maxxcantu/microcontroladores/README.md

# microcontroladores

Final Project.
University: Universidad Nacional de Cuyo.
Subject: Microcontrollers and Power Electronics.
Project: Prototype of a light folower differential drive mobile robot.
Developed in an Atmel328P microcontroller in Microchip Studio environment, simulated in Proteus and physically builded.

In this repository you can see all the code files in C, the simulation file of Proteus and the project report in spanish.
Also there is a demonstrative video to see the robot builded and in function.
