maxxcantu/microcontroladores/MyEP Informe Proyecto Integrador-Cantu_v2.pdf

Mendoza - Argentina

# PROTOTIPO DE ROBOT ASISTIDOR DE

# COSECHA

PROYECTO INTEGRADOR

Microcontroladores y Electronica de Potencia ´ Profesor Titular: Ing. Eduardo E. Iriarte

Cantu Tsallis, Maximiliano – 11294 ´

Ano: 2022 ˜

Proyecto Integrador - Prototipo Robot Asistidor de Cosecha | Cantu Tsallis, Maximiliano ´

# RESUMEN

El objetivo principal del proyecto es lograr disenar, simular y controlar el movimiento de un proto- ˜ tipo físico y a escala de un robot asistidor de cosecha, el cual sea capaz de seguir constantemente al operario durante el proceso, transportando el cajon de uva a una distancia y velocidad deseada. ´ Esto es con el fin de evitarle al operario el trabajo de cargar, trasladar y descargar el cajon cada ´ vez que necesite moverse, ya que esos movimientos suelen ser de distancias cortas y resulta agotador realizarlos repetidas veces en poco tiempo, generando un desgaste corporal y una perdida de tiempo.
Para lograrlo, se desarrollara un modelo a escala con simplificaciones y diferencias respecto al ´
proyecto final, las cuales se tendran en cuenta como mejoras a futuro para completar la realizaci ´ | on´
y fabricacion del proyecto en su totalidad. ´
MICROCONTROLADORES Y ELECTRONICA DE POTENCIA | 1 de 19 ´

## Índice

RESUMEN | 1
INTRODUCCION´ | 3
DESARROLLO | | | 5
1. Descripcion de l ´ | ogica y conexiones de hardware ´ | 5
2. Descripcion de perif ´ | ericos y c ´ | odigo ´ | 10
3. Funcionamiento General | 13
PUESTA EN MARCHA | 15
ANALISIS DE INGENIER ´ | ÍA | 17
CONCLUSIONES | 18
REFERENCIAS | 19

# INTRODUCCION´

El proyecto que se presenta a continuacion tiene como objetivo la aplicaci ´ | on de los conocimientos ´
adquiridos en la catedra de Microcontroladores y Electr ´ | onica de Potencia de la carrera de Ingenier ´ | ía
en Mecatronica en la Universidad Nacional de Cuyo. ´
La idea de realizar este proyecto surge de una experiencia propia vivida el ano pasado, cuando ˜ tuve que trabajar haciendo temporada en la cosecha de uva de lunes a lunes todo el día. Mientras realizaba mi trabajo notaba que había acciones simples, pero repetitivas, y que con el correr de los días se tornaban cada vez mas desgastantes por el cansancio y la fatiga que el cuerpo iba acumu- ´ lando. Una de ellas era la de cargar y descargar el cajon de uvas a medida que se iba avanzando ´ con la cosecha sobre la hilera de parcelas, lo cual era muy frecuente ya que como la distribucion de ´
los racimos no era homogenea, hab ´ | ía sectores con gran cantidad de racimos para cosechar, lo cual
equivale a mayor tiempo en una misma posicion, pero hab ´ | ían otros sectores con muy pocos raci-
mos en los que se perdía mas tiempo trasladando el caj ´ | on, parcialmente lleno de uva, unos pocos ´
metros para continuar el proceso. Es por esto que me surge la necesidad de pensar una forma para evitar dicho desgaste físico y perdida de tiempo, totalmente desfavorable para el objetivo principal ´ del trabajo, el cual era cosechar la mayor cantidad de uva de buena calidad y en el menor tiempo posible.
Como bien es sabido, en los pueblos o regiones en los que la actividad vitivinícola es uno de
sus pilares economicos, la ´ | epoca de vendimia es una costumbre y una tradici ´ | on compartida entre ´
familiares, amigos y vecinos y de la cual todos forman parte en diferentes etapas del proceso, por lo
tanto, no esta bien visto el reemplazar completamente el proceso de cosecha por robots o m ´ | aquinas ´
automatizadas que lo realicen; y ademas, la correcta selecci ´ | on de la uva tambi ´ | en es muy importante ´
para obtener un buen producto final y de calidad. Por otro lado, tambien hay que tener en cuenta el ´
factor economico, el cual tambi ´ | en es muy importante, ya que no se justifica invertir grandes sumas ´
de dinero por una maquina cosechadora si realizarlo manualmente es m ´ | | as barato y se obtiene un ´
mejor producto final.
Teniendo en cuenta las limitaciones previamente mencionadas, es que pienso en los robots colaborativos, los cuales son destinados a trabajar en conjunto con un operario, pero sin quitarle el trabajo por completo al mismo. Logrando crear un robot que sea capaz de resolver el problema principal, el de cargar y trasladar los cajones repetidas veces en un periodo corto de tiempo, pero sin
interferir en el proceso de seleccion y cosecha del fruto, ser ´ | ía lo ideal para lograr una cosecha mas´
rapida y con una peque ´ | na mejor ˜ | ía en cuanto al desgaste físico del operario; y sin necesidad de inver-
tir grandes sumas de dinero en la compra de maquinas cosechadoras o vendimiadoras industriales, ´ que rondan valores entre los US$250.000 y los US$350.000, aproximadamente.
La idea global del proyecto es implementar un robot diferencial de orugas, debido a que su apli-
cacion seria principalmente en terrenos hostiles y dificultosos, no se requerir ´ | an altas velocidades de ´
movimientos y si sera necesaria una gran tracci ´ | on en el terreno para trasladar cargar entre los 2 ´
y los 20 kilogramos aproximadamente. El movimiento sería guiado por una tobillera colocada en el
operario y con comunicacion infrarroja con el aut ´ | omata, de manera que pueda sensar y calcular la ´
distancia a la cual se encuentra el operario, es decir la tobillera, y mediante una logica determinar ´ si es necesario moverse hacia adelante para seguir al operario o moverse hacia atras para alejarse ´
del mismo. Ademas, dependiendo de la direcci ´ | on de la cual proviene la se ´ | nal infrarroja, el aut ˜ | omata ´
sería capaz de girar hacia un lado o hacia el otro, mediante la activacion de uno de los motores ´ | uni- ´
camente; cuando el operario deba girar en una hilera o comenzar con una nueva. El robot contaría con un potenciometro para que el operario pueda modificar manualmente y a su gusto la velocidad ´
de movimiento hacia adelante y hacia atras, seg ´ | un sea necesario; la velocidad de giro ser ´ | ía cons-
tante sin posibilidad de modificarse. Se opta por colocar un potenciometro en lugar de panel t ´ | actil, ´
teclado numerico o interfaz LCD, debido a que el ambiente tambi ´ | en seria hostil y el robot deber ´ | ía
ser lo mas rudimentario y robusto posible, y tambi ´ | en debido a que se debe tener en cuenta que el ´
operario tendría guantes con suciedad colocados. Por ultimo, el operario contar ´ | ía con un pulsador

sin retencion para setear el robot en un estado de reposo y que el mismo no lo siga hasta que se ´ vuelva a presionar el mismo pulsador; esto sería util en el caso que el operario desee alejarse del ´ mismo para realizar alguna tarea temporal en la cual no requiera el seguimiento del robot.
Para el presente proyecto, se optaría por hacer algunas modificaciones a lo previamente mencionado debido a que la idea global completa sería considerada para presentarla como proyecto final de
la carrera, implementandole conceptos y pr ´ | acticas de diferentes materias. Se modificar ´ | an los sen- ´
sores infrarrojos por sensores de luz tipo LDR, 3 para ser mas espec ´ | ífico, 1 sensor frontal, 1 sensor
lateral izquierdo y 1 sensor lateral derecho. Las orugas se reemplazaran por 2 ruedas traseras con- ´ ducidas por 2 motorreductores de CC controlados por 1 controlador L298N y 1 rueda “loca” frontal.
El automata ser ´ | ía alimentado por una batería externa recargable, la cual sea facilmente extra ´ | íble y
reemplazable si llega a ser necesario.
En este informe se expondra la l ´ | ogica de funcionamiento del robot, as ´ | í como el codigo realizado ´
y cargado en el microcontrolador, la implementacion del prototipo, sus conexiones el ´ | ectricas y su ´
montaje final con las partes mecanicas necesarias. ´

# DESARROLLO

1. Descripcion de l ´ | ogica y conexiones de hardware ´
En el desarrollo del automata, primero se ide ´ | o la l ´ | ogica de funcionamiento, la cual est ´ | a dada en ´
la Figura 1 y se tienen en cuenta los diferentes movimientos del robot en funcion de la intensidad y ´ de la direccion de la luz incidente en los sensores. Se configuraron 4 valores constantes de luz para ´
la comparacion, los cuales generan una banda proporcional de velocidades de movimientos seg ´ | un´
la intensidad de luz recibida por el sensor frontal. Esta banda esta dada por los valores constantes ´ de LUZ – MIN – MIN, LUZ – MIN, LUZ – MAX y LUZ – MAX – MAX, donde lecturas menores que
LUZ – MIN – MIN y LUZ – MIN generaran un movimiento de avance a diferentes velocidades seg ´ | un´
el valor de dicha lectura; y lecturas mayores que LUZ – MAX y LUZ – MAX – MAX generaran un ´ movimiento de retroceso a diferentes velocidades segun el valor de dicha lectura. Estos movimientos ´ deben ejecutarse hasta que el valor de la intensidad de luz se encuentre comprendido en los valores LUZ – MIN y LUZ – MAX, los cuales determinaran la distancia a la cual el robot debe mantenerse ´ del operario.
Para el giro, se realiza una comparacion entre los valores de lectura de cada uno de los sensores ´ laterales, con el del sensor frontal. En el momento en el que uno de los valores laterales sea mayor al frontal, el robot activa solo el motor correspondiente al lado contrario de la luz sensada, a una velocidad constante y fija, para generar un giro hacia el lado proveniente de la luz hasta que esta sea detectada por el sensor frontal, continuando con la logica de avance y retroceso comentada ´ anteriormente.

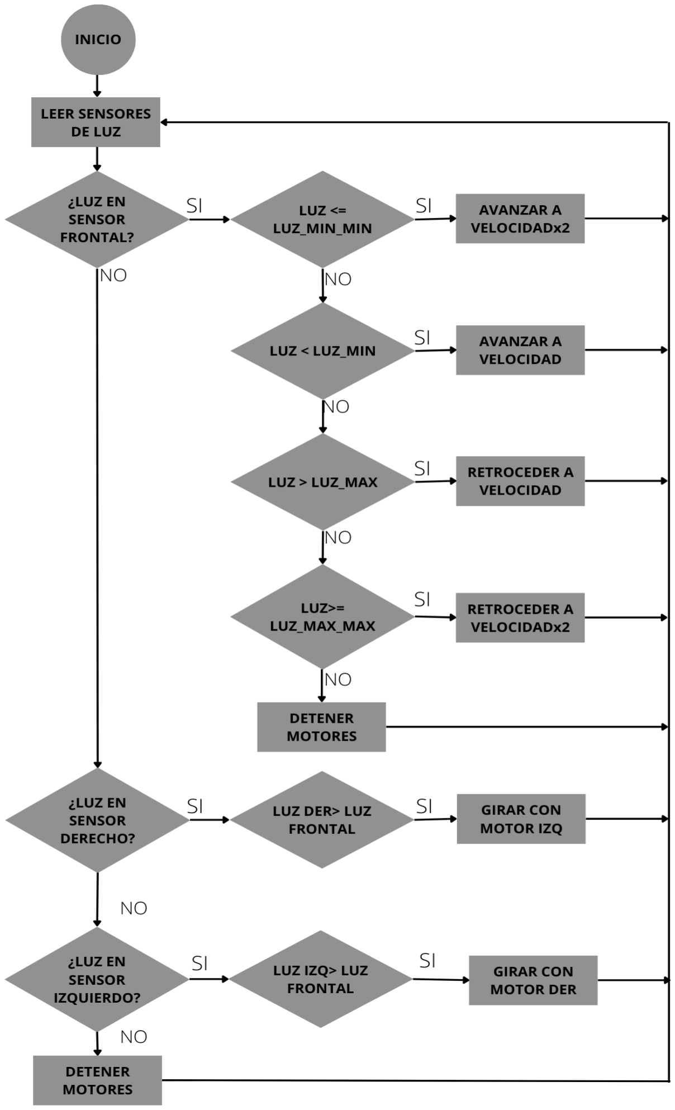
[picture p1: figure]

Figura 1: Diagrama de Flujo

Para implementar la logica descripta anteriormente en un prototipo f ´ | | ísico, se utilizara una placa ´
Arduino UNO la cual contiene un microcontrolador ATmega 328P de la familia AVR, 1 controlador de motores L298N, 2 motores DC del tipo motorreductores acoplados a 1 rueda en cada uno, 3 sensores de luz LDR con una resistencia de pull-down en cada uno, 1 potenciometro de 1kohm, 2 LED’s y 1 ´
pulsador sin retencion. Este ´ | ultimo componente se conecta con resistencia pull-up para evitar un ´
falso flanco en alto si se rompe el pulsador y su aplicacion en el aut ´ | omata real ser ´ | ía colocado en la
tobillera del operador, ya que es necesario que sea accesible de forma directa y remota, y no en el
robot mismo; pero por razones practicas, en el prototipo en cuesti ´ | on se lo implementa en el mismo ´
cuerpo del robot.
El correcto funcionamiento del automata depende principalmente de los sensores de luz LDR ´ (Resistencia Dependiente de Luz, por sus siglas en ingles) o fotorresistencias, los cuales cuentan con ´
una resistencia cuyo valor varía en funcion de la luz que est ´ | en recibiendo. Es muy peque ´ | na cuando ˜
recibe una luz muy intensa (unos pocos ohms), y aumenta su valor a medida que disminuye la intensidad de la luz que recibe. Para realizar la conexion de cada uno de los sensores, se implementa ´ un circuito divisor de tension con una resistencia de 10kohm, que permite traducir el cambio de ´
resistencia a un cambio de voltaje que sea posible leer en el pin analogo del Arduino, sin da ´ | nar el ˜
microcontrolador.

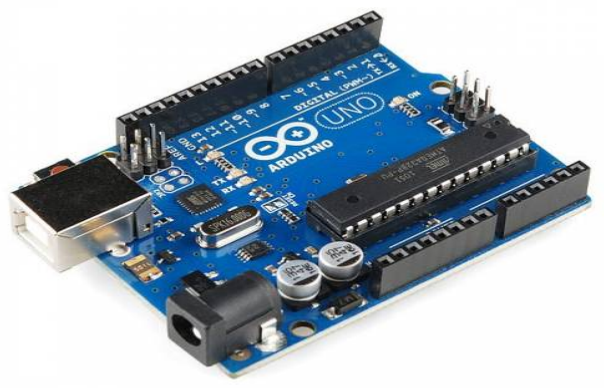
[picture p2: figure]

Figura 2: Arduino UNO

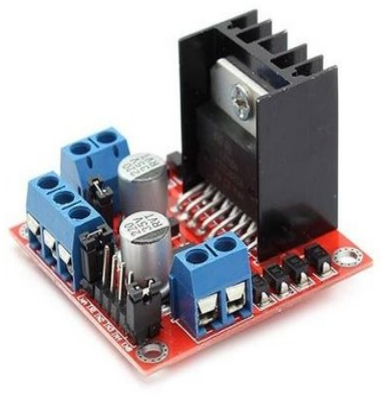
[picture p3: figure]

Figura 3: L298N

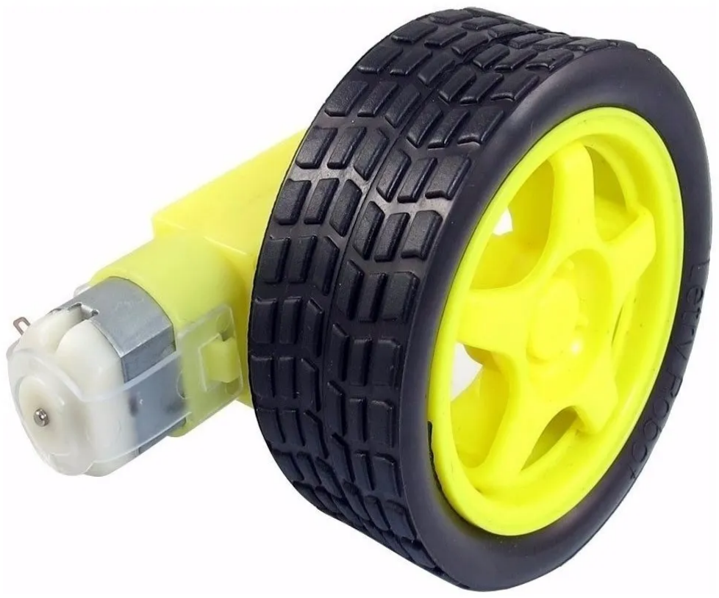
[picture p4: figure]

Figura 4: Motor DC con rueda

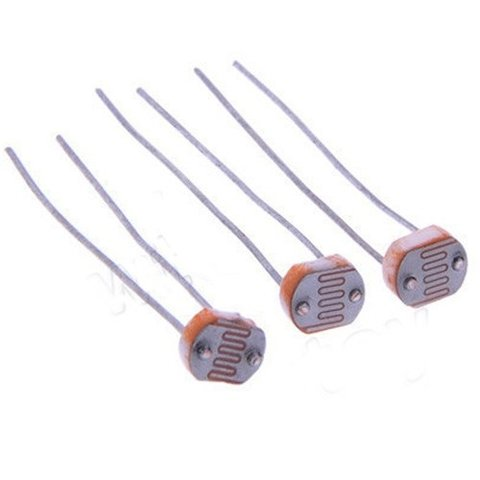
[picture p5: figure]

Figura 5: Sensores de luz LDR

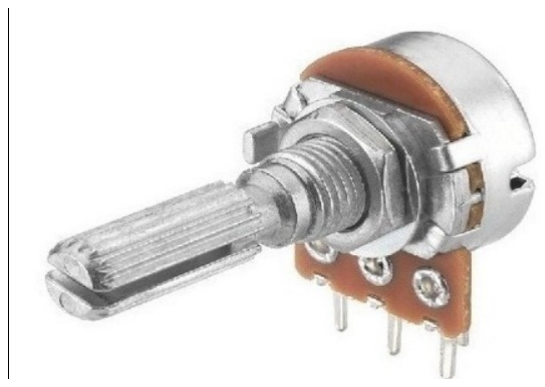
[picture p6: figure]

Figura 6: Potenciometro

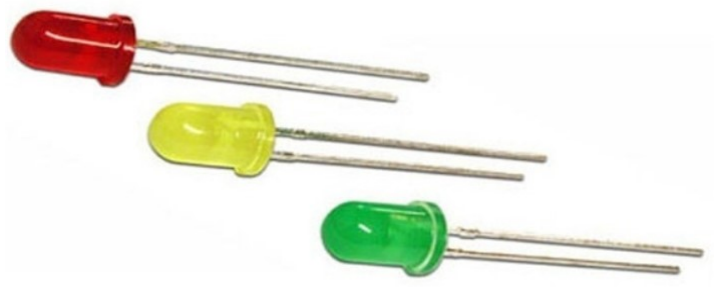
[picture p7: figure]

Figura 7: LED’s

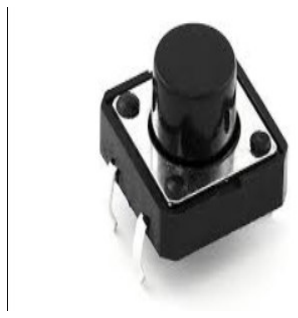
[picture p8: figure]

Figura 8: Pulsador sin retencion´

La conexion de los elementos electr ´ | onicos mencionados anteriormente, se pueden ver en la fi- ´
gura 9, en el cual se muestra la alimentacion como una pila de 9V, pero en el prototipo se utilizan ´ 2 pilas recargables de litio-ion de 3.7V y 7800mAh cada una, conectadas en serie, entregando una tension de aproximadamente 8V cuando se encuentran completamente cargadas. Estas pilas se uti- ´ lizan para alimentar el controlador L298N de los motores y por separado la placa arduino, utilizando un circuito de proteccion para la misma, compuesto por un diodo 1N4001 y un capacitor de 25V y ´ 100uF.

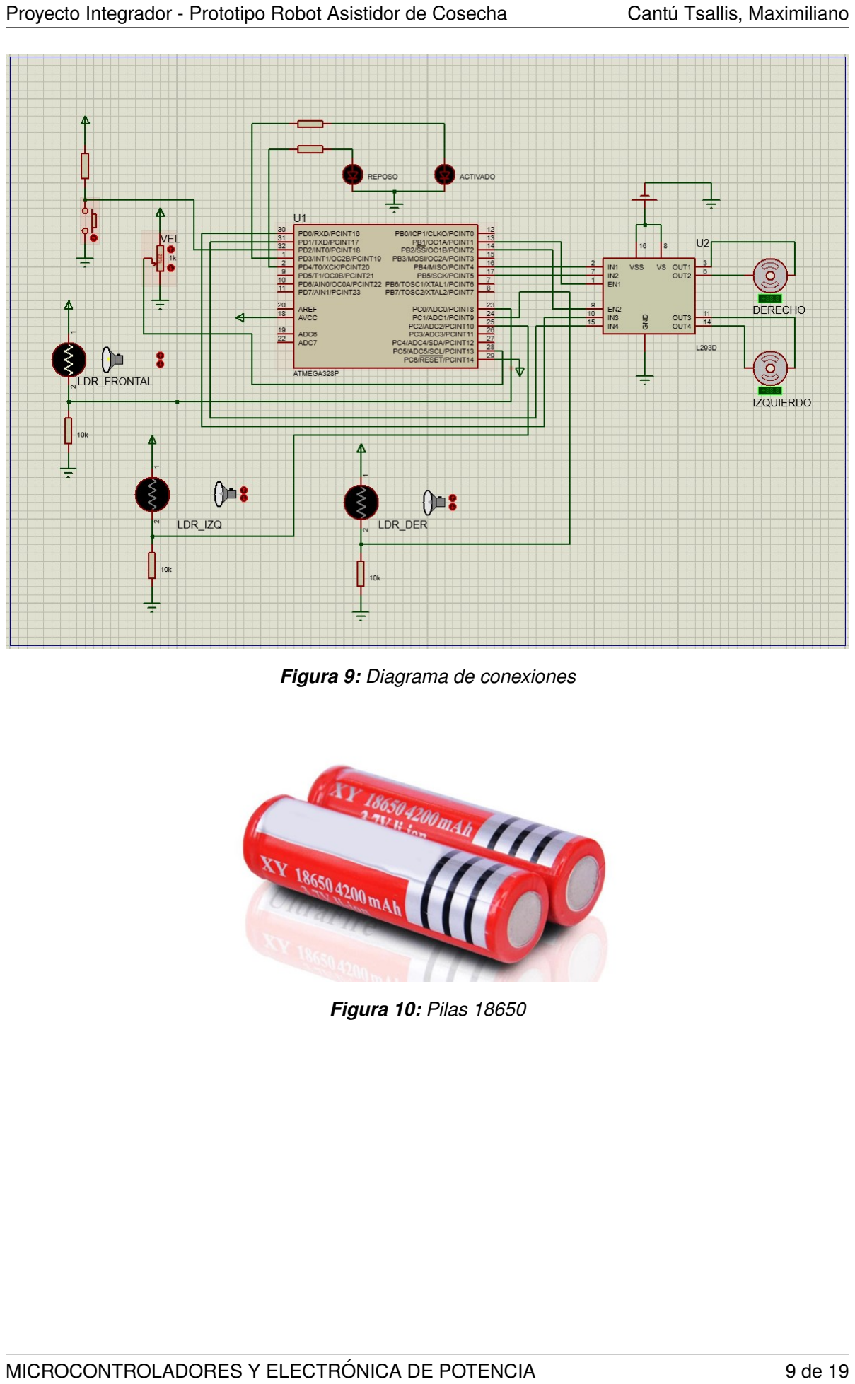
[picture p9: page 10]

Figura 9: Diagrama de conexiones

Figura 10: Pilas 18650

2. Descripcion de perif ´ | ericos y c ´ | odigo ´
En esta seccion se describir ´ | an los perif ´ | ericos utilizados del microcontrolador, seg ´ | un el esquema ´
de entradas y salidas que se puede visualizar a continuacion: ´

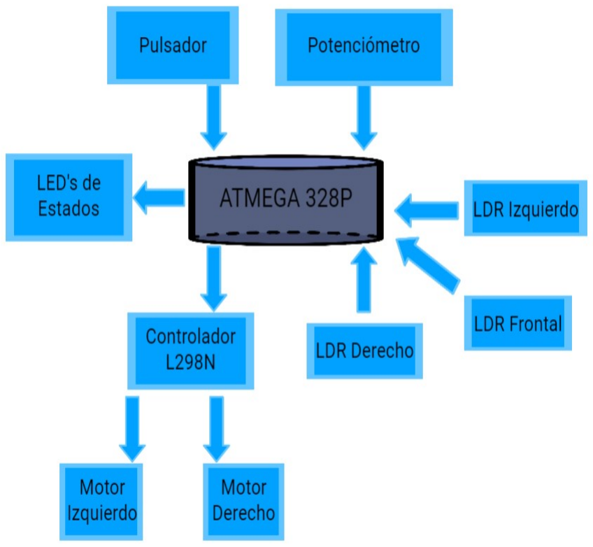
[picture p10: figure]

Figura 11: Esquema de E/S

Tal como se describio anteriormente, y como se puede ver en la figura ´ | | 11, el microcontrolador
realiza 1 lectura digital proveniente del pulsador de estado, 4 lecturas analogicas provenientes de los ´
sensores de luz y del potenciometro, y siguiendo la l ´ | ogica explicada previamente, escribe se ´ | nales ˜
digitales en el controlador de los 2 motores y en los 2 led’s de estado.
Por un lado, la lectura digital del pulsador para el cambio de estado se realiza mediante una rutina de servicio de interrupcion (ISR) en el bit INT0, configurada en modo CLEAR, en el cual solo ´ se produce la interrupcion al detectar un flanco de subida y permite cambiar el estado en el que se ´
encuentra el automata. En estado ACTIVADO, funciona seg ´ | un la l ´ | ogica explicada previamente; y en ´
estado de REPOSO, no responde ante ningun cambio de luz ni velocidad, es decir, se encuentra ´ encendido pero detenido completamente.
Continuando con las lecturas, para realizar las lecturas analogicas, se utiliza su conversor anal ´ | ogi- ´
co digital (ADC) de 10 bits. Primero se inicializa, se habilita para realizar la lectura y luego de cada una de estas, se deshabilita con el registro correspondiente para poder realizar correctamente la lectura siguiente, la cual proviene de un sensor diferente, es decir, un canal diferente. Para la utiliza-
cion del ADC, previo a la inicializaci ´ | on, se lo configura para realizar conversiones a una frecuencia ´
de 125kHz colocando su divisor de frecuencia en 128, para que dicho valor de frecuencia este com- ´ prendido entre los 50kHz y 200kHz.
Los valores de los 3 sensores son utilizados tal cual son leídos, pero, el valor del potenciometro ´ con el cual se setea la velocidad de avance y retroceso, es necesario escalarlo ya que para valores bajos no se logra ningun efecto en la velocidad de los motores debido al par resistente que se ´ debe vencer para que el robot se mueva. Para lograr determinar la escala a aplicar, se procedio a ´
medir con un multímetro la tension a la cual comenzaban a moverse, ya que para valores de tensi ´ | on´
menores, no se movían y solo se escuchaba una especie de pitido proveniente de los mismos.
Teniendo la lectura de dicha tension y sabiendo que el potenci ´ | | ometro es de 1kohm, es posible ´

calcular la resistencia para la cual los motores vencen el par resistente y así encontrar la formula ´ | 2.1
que permite escalar el valor leído, para que un valor bajo de lectura sea suficiente para mover los motores a una velocidad mínima.

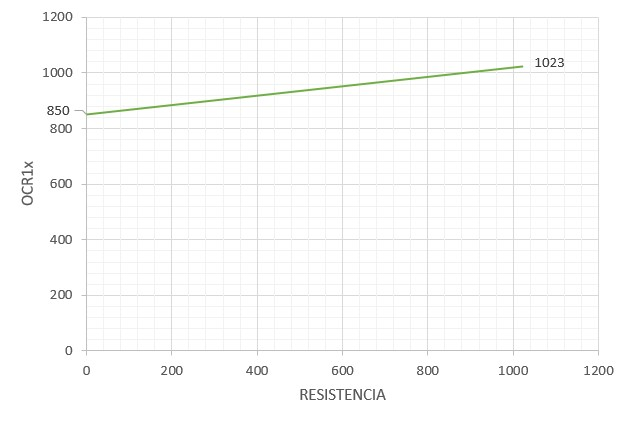
[picture p11: figure]

Figura 12: Resistencia potenciometro vs. OCR1x ´

OCR1x = Rpotenciometro ∗ 0.17 + 850 | (2.1)

Por otro lado, para modificar y escribir el valor de velocidad de cada uno de lo motores, se utiliza el Timer1 en modo FAST PWM - 10 bits, donde el periodo estara dado por un valor fijo de 1023 y ´
el ancho de pulso sera modificado seg ´ | un el valor escalado le ´ | ído por el potenciometro y la l ´ | ogica de ´
movimiento. El timer se configurara en el modo indicado, con un prescaler de 1 y en modo CLEAR; ´
y se utilizaran sus 2 registros OCR1x para generar la se ´ | nal PWM de 15,6kHz aproximadamente, el ˜
OCR1A para el motor izquierdo y el OCR1B para el motor derecho. El valor de la frecuencia PWM mencionada surge de realizar el siguiente caluclo: ´
| fPWM =

fclk
N ∗ (1 + TOP) | (2.2)

Donde:
fPWM: Frecuencia del PWM
fclk: Frecuencia de clock del microcontrolador = 16MHz N: Prescaler = 1
TOP: Valor maximo del contador del timer = 1023 ´

Para obtener un valor de (2.2) de 15,6kHz se optaron por usar los valores de prescaler y TOP
previamente mencionados, ya que simplifican los calculos con el uso del potenci ´ | ometro y se obtiene ´
un valor de frecuencia del PWM aceptable para los motores y el driver utilizados. Ademas, en la ´ practica el movimiento de ambos motores es de manera correcta. ´
En los movimientos de avance y retroceso, se escribiran los mismos valores en ambos registros, ´
es decir, las ruedas giraran a la misma velocidad. Previo a la escritura de cada registro, se realizar ´ | á
una saturacion de cada uno de ellos, para asegurarnos que los valores no superar ´ | an el m ´ | aximo ´
admitido correspondiente a 1023. En cambio, para realizar los giros, se escribira solo uno de los ´ registros, segun el sentido de giro deseado, escribiendo un 0 en el otro. ´

Para finalizar, la escritura digital en los LED de estado, se realiza segun el estado en el que se ´ encuentra el automata, modificado por el pulsador previamente explicado. Cuando se encuentra en ´ REPOSO, se escribira un 1 en el bit correspondiente al LED amarillo y un 0 en el bit correspondiente ´ al LED verde; al cambiar al estado de ACTIVADO, se pone en 0 el LED amarillo y en 1 el verde.

## 3. Funcionamiento General

En esta seccion se explicar ´ | a la secuencia de funcionamiento que seguir ´ | a el robot, seg ´ | un la ´
programacion realizada para el mismo. ´
Primero se encendera con un interruptor tipo ON-OFF que alimentar ´ | a el circuito de la placa ´
arduino y del controlador de los motores. Al iniciar el programa principal, se configuran los pines de
salida de las senales PWM, la interrupci ˜ | on del pulsador de estado, se inicializa el conversor ADC, se ´
setea el valor de la velocidad de giro y por ultimo se habilitan las interrupciones globales. Luego de ´ realizar todas las configuraciones previas, se indica que el robot se encuentra inicialmente en estado de REPOSO para que los valores de lecturas se realicen cuando se tenga lista la fuente de luz con la que se guiara al mismo. ´
Al encontrarse el usuario preparado, se procede a pulsar el pulsador para pasar al estado ACTI-
VADO y que comience el movimiento segun la l ´ | ogica planteada en la figura ´ | 13. El programa continua
ejecutando cíclicamente las consignas que se encuentran dentro del bucle y dentro del estado AC-TIVADO, es decir, comparanado los valores de luz y asignando los valores del ancho de pulso a los
registros OCR1X segun la lectura en el potenci ´ | ometro. ´
Si se presiona nuevamente y en cualquier momento el pulsador de estado, el robot vuelve instantaneamente al estado de REPOSO, encendiendo el LED indicador correspondiente y apagando ´ el timer que controla los motores.
Por ultimo, el robot cuenta con un estado de ERROR, el cu ´ | al solo se presentar ´ | a en el caso de ´
que la lectura de los valores analogicos de los sensores LDR sean an ´ | omalos, es decir, superiores a ´
1023 o inferiores a 0. A este estado se lo considera como un estado de seguridad frente a fallas o comportamientos inesperados por parte de los sensores, del microcontrolador o cualquier otro factor que afecte la lectura real de la intensidad de luz. Al presentarse alguno de los casos mencionados, el
robot se detendra, se encender ´ | an los 2 LED’s indicadores (el verde y el amarillo, simult ´ | aneamente) ´
y se mantendra en ese estado hasta que se realice un reseteo por hardware, es decir, apagarlo y ´ encenderlo nuevamente manualmente con el interruptor ON-OFF mencionado. Es importante tener en cuenta que si sucede una falla, previo a resetearlo por hardware, es prioritario revisar y solucionar el motivo de la falla, para que no vuelva a ocurrir.

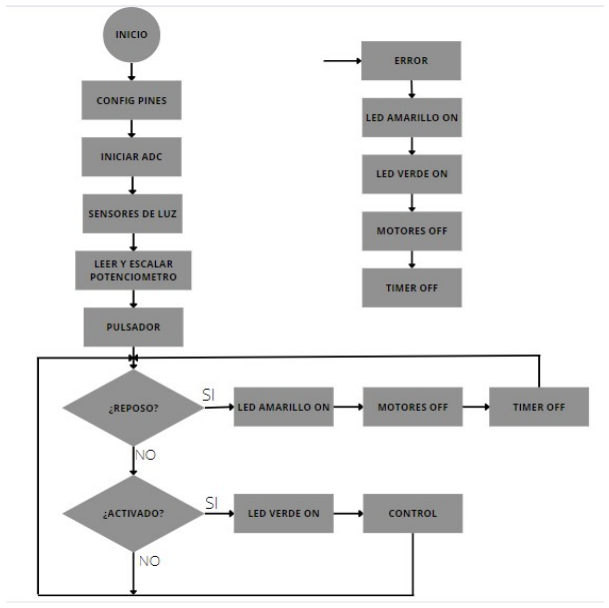
[picture p12: figure]

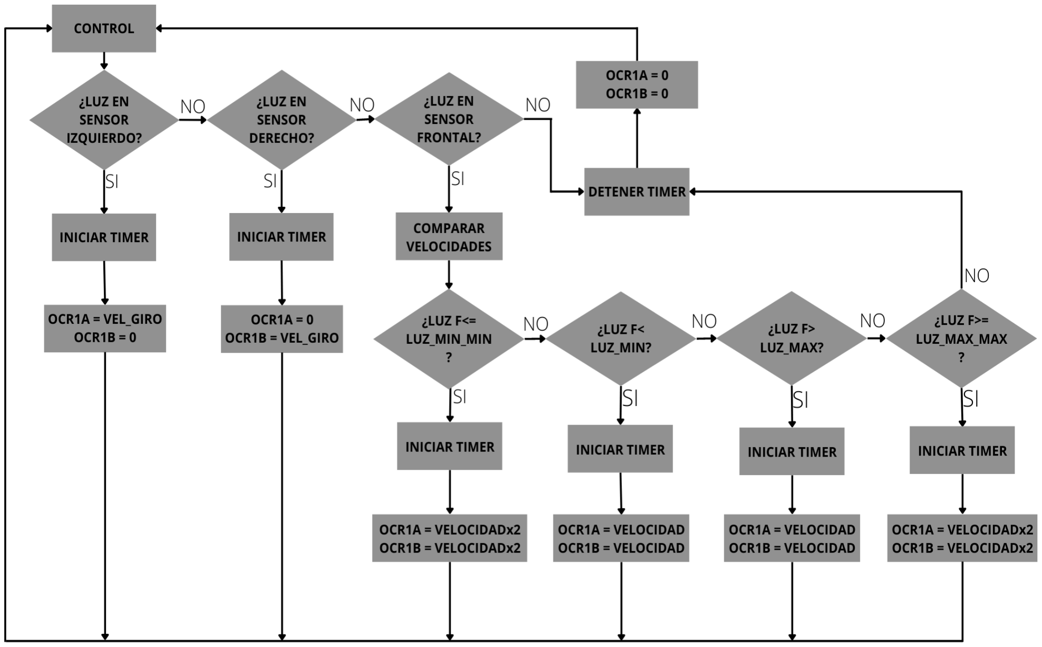
[picture p13: figure]

Figura 13: Diagrama de Flujo completo

# PUESTA EN MARCHA

En esta seccion se comentar ´ | an los resultados obtenidos luego de la puesta en marcha del robot, ´
con una fuente de luz y modificando su velocidad y estados.
A continuacion se puede ver una foto del prototipo final obtenido con la implementaci ´ | on de todo ´
lo mencionado en este informe y sus conexiones tanto electricas como de control. ´

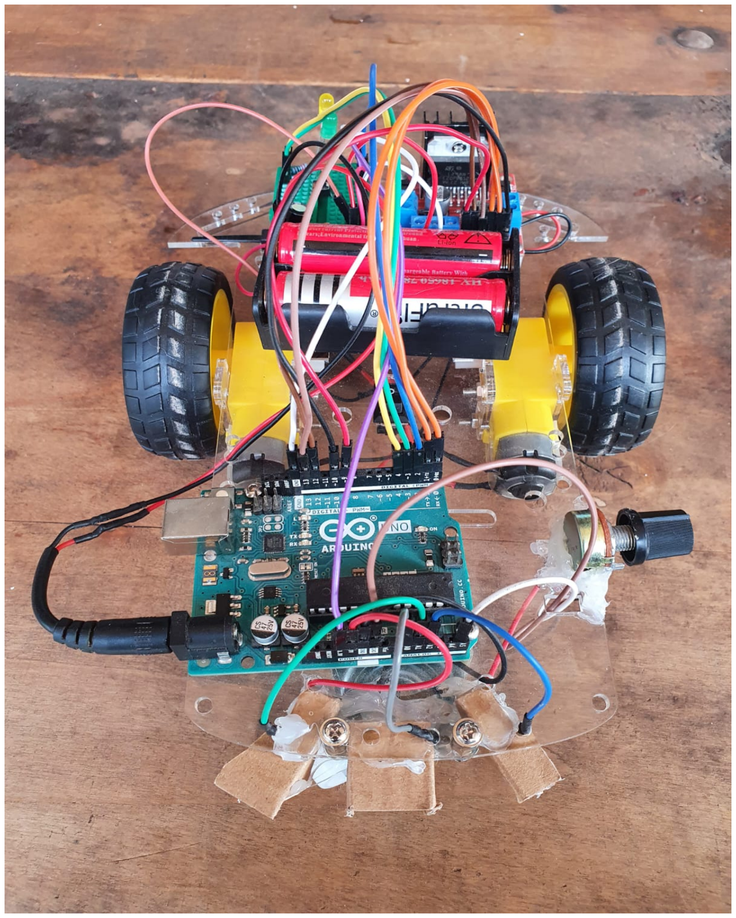
[picture p14: figure]

Figura 14: Prototipo Final 1

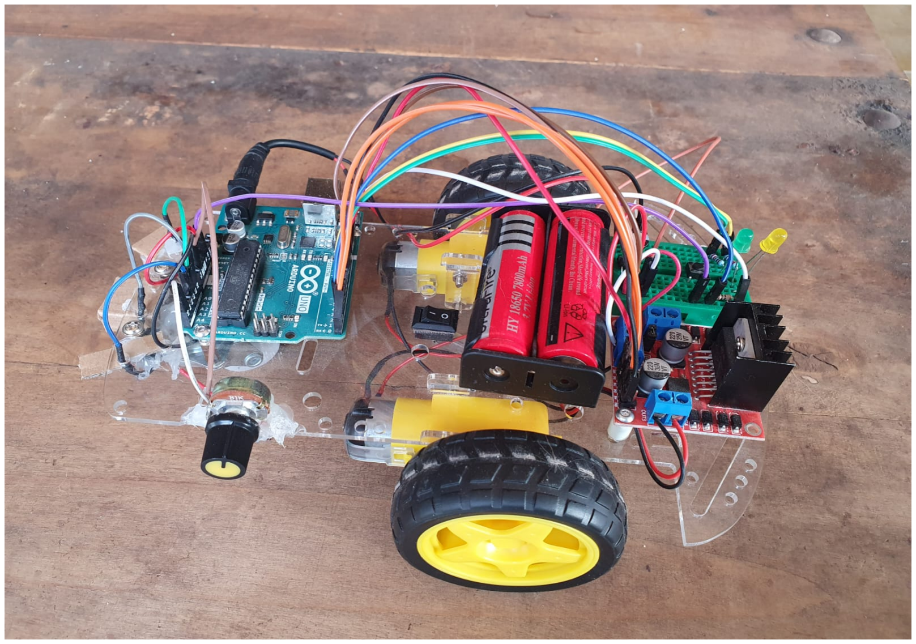
[picture p15: figure]

Figura 15: Prototipo Final 2

Las pruebas del funcionamiento real del prototipo de robot asistidor de cosecha se realizaron en una habitacion pr ´ acticamente oscura, para que no hayan luces que confundan al mismo y modifiquen ´ su funcionamiento, mas alla de que el mismo cuenta con una especie de ojeras en cada sensor, para ´

que se tenga ponga influencia de la luz ambiental en la lectura de los sensores LDR. Ademas, se ´ utilizo una linterna de celular, colocado en un palo extensible con agarre de celulares en su extremo, ´ típicamente conocido como ”palo selfie”.

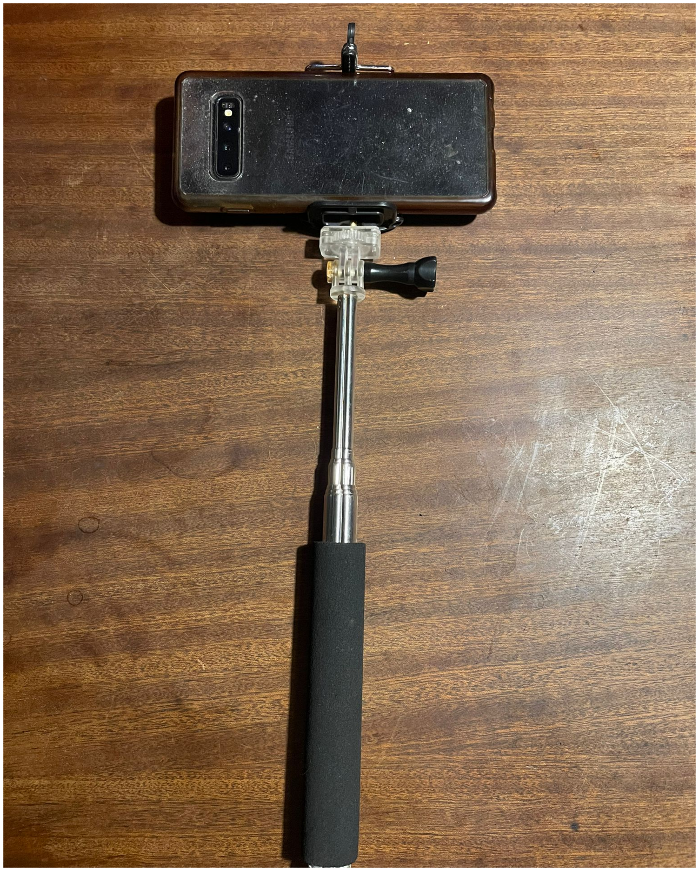
[picture p16: figure]

Figura 16: Celular + Palo Selfie

Se procedio a encender el robot, colocar el celular con su linterna encendida en una posici ´ | on´
enfrentada al mismo y luego se presiono el bot ´ | on de cambio de estado para activarlo. Manteniendo ´
el potenciometro al m ´ | ínimo, el robot lo primero que hizo fue moverse hacia atras para cumplir con la ´
consigna de mantener una distancia constante con el celular.
Al comenzar a mover el celular, agarrandolo mediante el palo mencionado, el robot continu ´ | o si- ´
guiendolo seg ´ | un se esperaba, probando giros abiertos y cerrados para cada lado, avances alejando ´
el celular y retrocesos acercandole el mismo. Con la intensidad de la luz que emite la linterna del ´
celular utilizado, se verifico que el robot manten ´ | ía una distancia de entre 50cm y 100cm aproxima-
damente.
Por ultimo, se comprob ´ | o que al modificar la velocidad de avance y retroceso con el potenci ´ | ometro ´
correspondiente, se veían reflejadas dichas modificaciones en sus movimientos, comprobando que la lecturas analogicas se realizaban correctamente y que la respuesta de los motores era adecuada ´
segun la l ´ | ogica de funcionamiento implementada en el microcontrolador. ´
Luego de varias pruebas, se verifico que en ninguna de las mismas se present ´ | o una falla o ´
un comportamiento anomalo en el robot y en sus lecturas, ya que nunca se habilit ´ | o el estado de ´
ERROR, es decir, nunca se vieron los led verde y amarillo encendidos simultaneamente. ´

ANALISIS DE INGENIER ´ | ÍA
En esta seccion se plantean las mejoras necesarias que permitir ´ | | | an llevar este prototipo a un ´
proyecto real, con un funcionamiento acorde a su implementacion pr ´ | actica. ´

Modificar los sensores LDR por sensores infrarrojos que reciban una senal infrarroja prove- ˜ niente de una tobillera colocada en el operario. En la misma se encontrara el boton de cambio ´
de estado, que se comunicara con el robot y el microcontrolador mediante una se ´ | nal de radio ˜
frecuencia, por lo tanto, en el robot habra un m ´ | odulo receptor de RF. Al realizar la modificaci ´ | on´
de los sensores, no sera necesaria una habitaci ´ | on oscura para su funcionamiento, ya que ser ´ | á
utilizado en terrenos exteriores, y el factor de la luz externa ya no sera tenido en cuenta ni ser ´ | á
influenciable.
El tamano final ser ˜ | a bastante mayor ya que le debe caber una caja de cosecha de 500mm x ´
300mm x 270mm, aproximadamente.

Las ruedas laterales y la rueda libre frontal serían reemplazadas por orugas con eje delantero y trasero, para poder desplazarse correctamente en terrenos hostiles y desnivelados.

Se realizara un an ´ | alisis din ´ | amico que ser ´ | ía utilizado en la seleccion de los motores para que ´
pueda soportar cargas extras de hasta 20kg aproximadamente, ya que es lo maximo que suele ´
pesar un cajon de cosecha lleno de uva, adem ´ | as de su propio peso con sus bater ´ | ías incluidas.

# CONCLUSIONES

En este proyecto se lograron aplicar gran cantidad de los temas estudiados y practicados en
la catedra Microcontroladores y Electr ´ | onica de Potencia. Por un lado, se implement ´ | o el manejo y ´
configuracion de timers generando se ´ | nales PWM, las cuales nos permitieron manejar los motores, ˜
modificando su velocidad mediante la modificacion de su ancho de pulso. Adem ´ | as, se utilizaron inte- ´
rrupciones tipo INT y se implemento el uso del conversor anal ´ | ogico digital, leyendo valores anal ´ | ogi- ´
cos de intensidad de luz y de resistencia variable de un potenciometro. ´
Los conocimientos adquiridos en clases teoricas y practicas, permitieron que se pudiera llevar a ´
cabo este proyecto, junto a un trabajo de investigacion y profundizaci ´ | on en ciertos temas; aprendien- ´
do a leer, interpretar y utilizar las hojas de datos de los fabricantes de los elementos utilizados.
Se logro materializar un prototipo del proyecto, pudiendo aprender sobre conexiones, alimenta- ´
cion y funcionamiento del mismo; ya que fue evidente que no es lo mismo trabajar con una simulaci ´ | on´
computacional que con un proyecto físico, en el cual las condiciones ideales no existen dado que hay una mayor probabilidad de error y de presencia de factores externos.
Al comprobar el funcionamiento del prototipo físico se pudo constatar que el mismo funciona de acuerdo a lo implementado en el codigo y en las conexiones, logrando un correcto movimiento ´ guiado por una fuente de luz.
Tal como se menciono al inicio del presente informe, este proyecto es un prototipo inicial de uno ´
de mayor complejidad y tamano, por lo tanto las mejoras a realizar ser ˜ | an apuntadas para implemen- ´
tar y obtener un proyecto final de acuerdo a la idea original.

# REFERENCIAS

https://electronilab.co/tutoriales/tutorial-de-uso-driver-dual-l298n-para-motores-dc-y-paso-a-pasocon-arduino/

Instructivo Atmel Studio y AVR

ATmega328P - 8-bit AVR Microcontroller with 32K Bytes In System - DATASHEET

L298N Datasheet

https://www.agrofy.com.ar/vendimiadora

Videos, diapositivas y apuntes de clase
