maxxcantu/microcontroladores/(list of files, drawings)

Other design files:
simu_PF.pdsprj
